NicoDiLowe/Project-rollingmill/README.md

# Project-rollingmill-movie
Link do filmiku pokazującego działanie Walcarki

https://drive.google.com/drive/folders/11p9NOj4PhE7RaiN2rmQmAnQRvKiUHgUT?usp=sharing
