NicoDiLowe/Project-rollingmill/Pinout.png

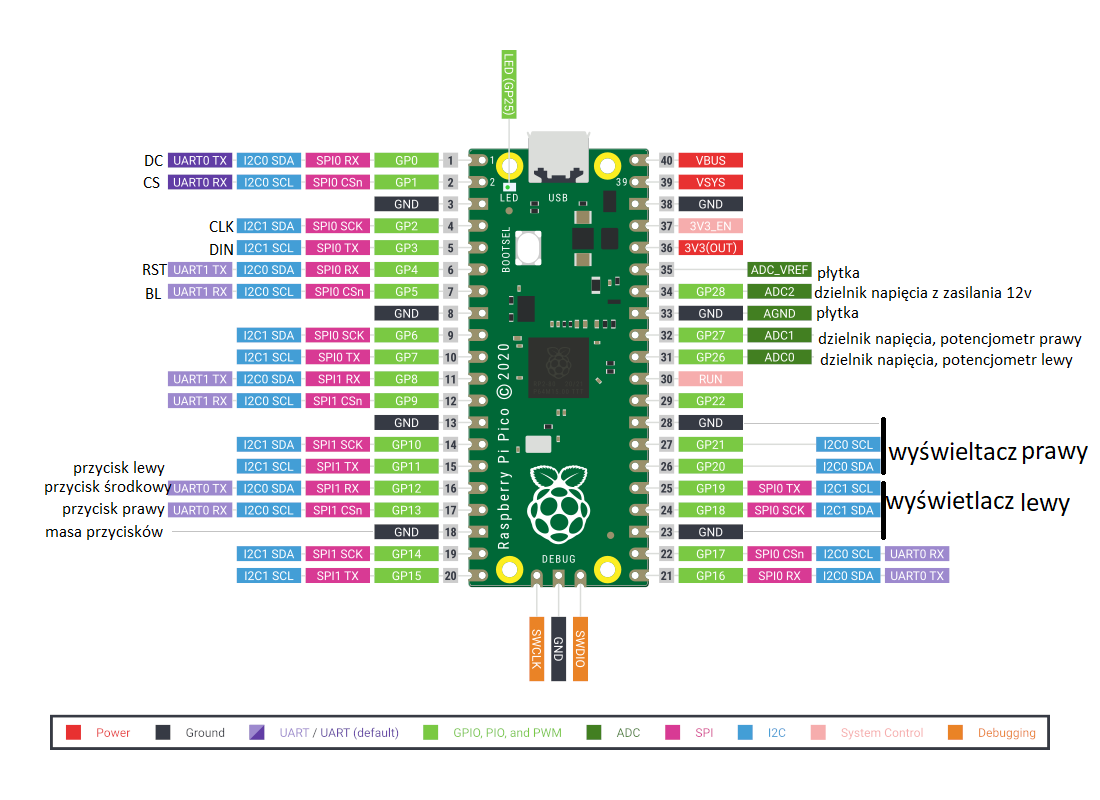
Pinout.png
