NicoDiLowe/Project-rollingmill/(list of files, drawings)

Other design files:
Program/TM1637TinyDisplay-master/examples/4-digit-display-basic.fzz
