NicoDiLowe/Project-rollingmill/Program/LCD_2inch4/LCD_2inch4.ino

#include <SPI.h>
#include "LCD_Driver.h"
#include "GUI_Paint.h"
#include "image.h"

void setup()
{
  Config_Init();
  LCD_Init();
  LCD_Clear(0xffff);
  Paint_NewImage(LCD_WIDTH, LCD_HEIGHT, 0, WHITE);
  Paint_Clear(WHITE);
  Paint_DrawString_EN(30, 10, "123", &Font24, YELLOW, RED);
  
  //Paint_DrawFloatNum (5, 150 ,987.654321,4,  &Font20,    WHITE,   LIGHTGREEN);

}
void loop()
{
  
}



/*********************************************************************************************************
  END FILE
*********************************************************************************************************/
