NicoDiLowe/Project-rollingmill/Program/LCD_2inch4/DEV_Config.h

/*****************************************************************************
* | File        :   DEV_Config.c
* | Author      :   Waveshare team
* | Function    :   Hardware underlying interface
* | Info        :
*                Used to shield the underlying layers of each master 
*                and enhance portability
*----------------
* | This version:   V1.0
* | Date        :   2018-11-22
* | Info        :

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
******************************************************************************/
#ifndef _DEV_CONFIG_H_
#define _DEV_CONFIG_H_

#include <stdint.h>
#include <stdio.h>
#include <SPI.h>
#include "Debug.h"
#include <avr/pgmspace.h>



#define UBYTE   uint8_t
#define UWORD   uint16_t
#define UDOUBLE uint32_t

/**
 * GPIO config
**/
#define DEV_CS_PIN  1
#define DEV_DC_PIN  0
#define DEV_RST_PIN 4
#define DEV_BL_PIN  5


/**
 * GPIO read and write
**/
#define DEV_Digital_Write(_pin, _value) digitalWrite(_pin, _value == 0? LOW:HIGH)
#define DEV_Digital_Read(_pin) digitalRead(_pin)


/**
 * SPI
**/
#define DEV_SPI_WRITE(_dat)   SPI.transfer(_dat)

/**
 * delay x ms
**/
#define DEV_Delay_ms(__xms)    delay(__xms)

/**
 * PWM_BL
**/
 #define  DEV_Set_PWM(_Value)  analogWrite(DEV_BL_PIN, _Value)

/*-----------------------------------------------------------------------------*/
 void Config_Init();
#endif
